Gab-s-fotio/wechselrichter-modellhaus/Wechselrichter_Modelhaus.ioc

Mcu.UserName=STM32F407VGTx
PA0-WKUP.Signal=ADCx_IN0
PA1.Signal=ADCx_IN1
PA8.Signal=S_TIM1_CH1
PB13.Signal=TIM1_CH1N
PC0.Signal=GPIO_Output
PC1.Signal=GPIO_Output
