Gab-s-fotio/wechselrichter-modellhaus/(commit log)

2026-10-06 Wechselrichter für ein Modellhaus: Firmware, Dokumentation und Präsentation
    STM32F407 + BTS7960 erzeugen 12 V AC / 50 Hz aus 24 V DC (SPWM mit
    TIM1 und DMA). Strom-, Spannungs- und Frequenzmessung im STM32,
    kalibriert gegen Oszilloskop-Messung. Projektphase THM, Gaby Fotio.
2026-10-06 README auf Englisch ergänzen, deutsche Fassung als README.de.md
